albertM-hub/rotor-g2800/(commit log)

2026-10-22 Contrôleur DIY pour rotor Yaesu G-2800DXC : firmware, interface, documentation
    - Firmware Arduino Nano (GS-232A) : interlock, pause d'inversion, limite 0-360°,
    détection de blocage, timeout 300 s, étalonnage 6 points
    - Interface Tkinter (carte en projection de Miller, cap QRZ, fenêtre redimensionnable)
    et scripts de test
    - Schéma, plan de plaque et guide de montage (câblage validé : ROUGE -> RL1/R, NOIR -> RL2/L)
    - Configuration locale hors dépôt (rotor_config.ini), licence GPL-3.0
2026-10-22 README : capture de l'interface, crédit Natural Earth, précision sur l'étalonnage
    - Fond de carte world_map.png régénéré depuis Natural Earth 1:50 M (domaine public),
    même projection de Miller que l'interface ; script tools/gen_world_map.py
    - Capture docs/appli-rotor.png affichée dans le README
    - Étalonnage : « graduation 30 » de la zone de recouvrement (= 390°)
2026-10-23 5 V en rotation mesuré sur trois points ; script b_rotation.py
    README : chute du 5 V avec bobines séparées corrigée (≈ 1,6 %, mesurée au
    multimètre sur l'ICSP, la broche +5V et REF, au lieu de 0,8 % lu par \B).
    scripts/b_rotation.py : rotation R de N secondes avec lecture de \B toutes
    les 0,5 s, arrêt S garanti.
    [b_rotation.py]
2026-10-23 README : lien vers l'article hamanalyst.org, b_rotation.py dans la liste des scripts
    Corrige aussi la note sur le port des scripts de test (constante PORT
    seulement pour cinq d'entre eux).
2026-10-27 Default station position to 0.0 and warn at startup when unconfigured
    QTH_LAT/QTH_LON now fall back to 0.0 instead of the JO20SP centre.
    When both are 0.0, a warning is printed on the console and shown in
    the GUI status panel; the program is never blocked.
